awalvie/gripswap/gripswap.scad

// gripswap: a 3D-printable lift block (a portable hangboard) with swappable inserts.
// Render one part, the right way up to print: openscad -D 'part="housing"' -D for_print=true -o housing.stl gripswap.scad
// Any parameter in src/ can be overridden the same way, for example -D slot_d=25.

part = "housing";
$fn = 48;

include <src/lib.scad>
include <src/config.scad>
include <src/housing.scad>
include <src/inserts/edge.scad>
include <src/inserts/pocket.scad>
include <src/inserts/roller.scad>
include <src/inserts/flip.scad>
include <src/fuzzy.scad>
include <src/refs.scad>
include <src/fit_test.scad>
include <src/texture_test.scad>

// for_print = true turns a printed part to the orientation in its print note and puts it on z = 0.
// The parts are modelled where they sit in the assembled block.
for_print = false;
module on_bed() {
    if (!for_print) children();
    else if (part == "housing") rotate([90, 0, 0]) children();   // front face down, the anchor plate flat on the bed
    else if (part == "insert_edge" || part == "insert_pocket" || part == "insert_flip"
             || part == "fuzzy_edge" || part == "fuzzy_pocket" || part == "fuzzy_flip")
        translate([0, 0, pk_d - clear]) rotate([-90, 0, 0]) children();   // on its back, front up: the grip stands upright
    else if (part == "insert_roller") translate([0, 0, -ins_bot]) children();  // floor down
    else if (part == "roller" || part == "roller_straight")
        translate([0, 0, roll_len/2]) rotate([0, 90, 0]) translate([0, -grip_y, -roll_z]) children();   // on one end
    else if (part == "axle") translate([0, -grip_y, axle_d/2 - roll_z]) children();     // lying down
    else if (part == "fit_ring" || part == "fit_frame") rotate([90, 0, 0]) children();   // front face down: the ring's flared first layer stays in its bevel, the frame's leads into the ring
    else children();
}

on_bed() {
    if (part == "housing") housing();
    if (part == "insert_edge") insert_edge();
    if (part == "insert_pocket") insert_pocket();
    if (part == "insert_flip") insert_flip();
    if (part == "fuzzy_edge") fuzzy_edge();
    if (part == "fuzzy_pocket") fuzzy_pocket();
    if (part == "fuzzy_flip") fuzzy_flip();
    if (part == "insert_roller") insert_roller();
    if (part == "roller") roller_any();
    if (part == "roller_straight") roller_straight();
    if (part == "axle") axle();
    if (part == "fit_ring") fit_ring();
    if (part == "fit_frame") fit_frame();
    if (part == "texture_test") texture_test();
    if (part == "texture_test_smooth") texture_test_smooth();
    if (part == "texture_test_mod") texture_test_mod();
}
if (part == "finger") finger();
if (part == "carabiner") carabiner(seat_z());
if (part == "pin") loading_pin(seat_z());
