awalvie/gripswap/(list of files, cad)

Other CAD files:
opengrips.scad
