awalvie/gripswap/PRINTING.md

# Printing gripswap

The printing guide is on the site: https://awalvie.github.io/gripswap/print.html

Its source is [web/static/print.html](web/static/print.html).
