awalvie/gripswap/TODO.md

# To do

- Photo of a printed kit and a short video of a pull, for the README.
- Load-test the housing to failure. Publish the load, how it failed, and the material, orientation, walls and infill.
- Load-test a housing with a 100% infill anchor plate against one without, to find out if the solid plate is needed.
- Measure edge pitch under load, for shallow, deep and ergo edges.
- Real filament grams and print times from a printed kit, to check the slicer numbers in the printing guide.
- Check the 0.3 mm insert clearance on a few printers with the fit test.
