awalvie/gripswap/(commit log)

2026-10-12 feat: hold inserts with front lips instead of a latch
    [config.scad, edge.scad, fit_test.scad, flip.scad, housing.scad, latch.scad, lib.scad, opengrips.scad]
2026-10-12 feat: print the housing on its front with one flat anchor plate
    [housing.scad, lib.scad, opengrips.scad]
2026-10-12 feat: make the housing shallower, with a 25 mm deepest edge
    [config.scad, roller.scad]
2026-10-12 feat: give each grip of the two-sided insert 22 mm of finger room
    [config.scad, flip.scad]
2026-10-12 feat: print the edge and pocket inserts on their backs
    The slot needs no supports this way, and the grip stands upright,
    so the slicer's fuzzy skin can reach it.
    [opengrips.scad]
2026-10-12 feat: add a fuzzy grip texture, fine, medium or coarse
    The STL stays smooth. A modifier file covers just the grip, and the
    slicer's fuzzy skin roughens the walls inside it.
    [flip.scad, fuzzy.scad, opengrips.scad]
2026-10-12 feat: let two-sided edges tilt in, up to 10°
    [flip.scad, fuzzy.scad]
2026-10-12 feat: add a Bambu and Orca 3MF for textured inserts
2026-10-13 feat: model lines, knurl and dots onto the grip
    [edge.scad]
2026-10-13 fix: shorten insert names in the kit list
2026-10-13 feat: add a texture test plate
    [opengrips.scad, texture_test.scad]
2026-10-13 feat: show the test prints as cards
2026-10-13 fix: hide edge-only patterns when a two-sided insert has no edge
2026-10-13 feat: make the texture test faster to print
    [texture_test.scad]
2026-10-13 refactor: rename opengrips to gripswap
    [housing.scad, opengrips.scad]
2026-10-13 refactor: rename opengrips.scad to gripswap.scad
    [gripswap.scad]
2026-10-15 feat: make the modeled grip patterns stronger
    Claude-Session: https://claude.ai/code/session_014MrpL44MJMDL3KsAqYsMc3
    [edge.scad]
2026-10-15 feat: name the slicer patterns after the board they feel like
    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
    [texture_test.scad]
2026-10-15 docs: make the solid anchor plate optional
    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
2026-10-15 test: check that inserts fit the housing
    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
2026-10-15 test: check that the roller insert fits the housing
    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
2026-10-15 fix: copy the insert before turning it in the fit check
    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
2026-10-15 docs: show the anchor plate in the housing print image
    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
2026-10-15 feat: move the printing guide onto the site
    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
2026-10-15 feat: put the printing guide in the zip
    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
2026-10-15 docs: update the filament numbers
    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
2026-10-15 fix: hang the preview carabiner from the top of the hole
    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
    [housing.scad]
2026-10-15 docs: give the axle rod length and the carabiner size
    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
2026-10-15 docs: call the hanging plate the anchor plate everywhere
    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
2026-10-15 docs: add for_print to the export example
    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
    [gripswap.scad]
2026-10-15 docs: shorten the printing guide
    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
